HexabitzPlatform/H0FR9x-Hardware/README.md

# H0FR9x-Hardware
Hexabitz 230V/10A(RMS) Enhanced SPDT Relay Module Hardware Design
