HexabitzPlatform/H0FR9x-Hardware/Documentation/H0FR9 Schematics.pdf

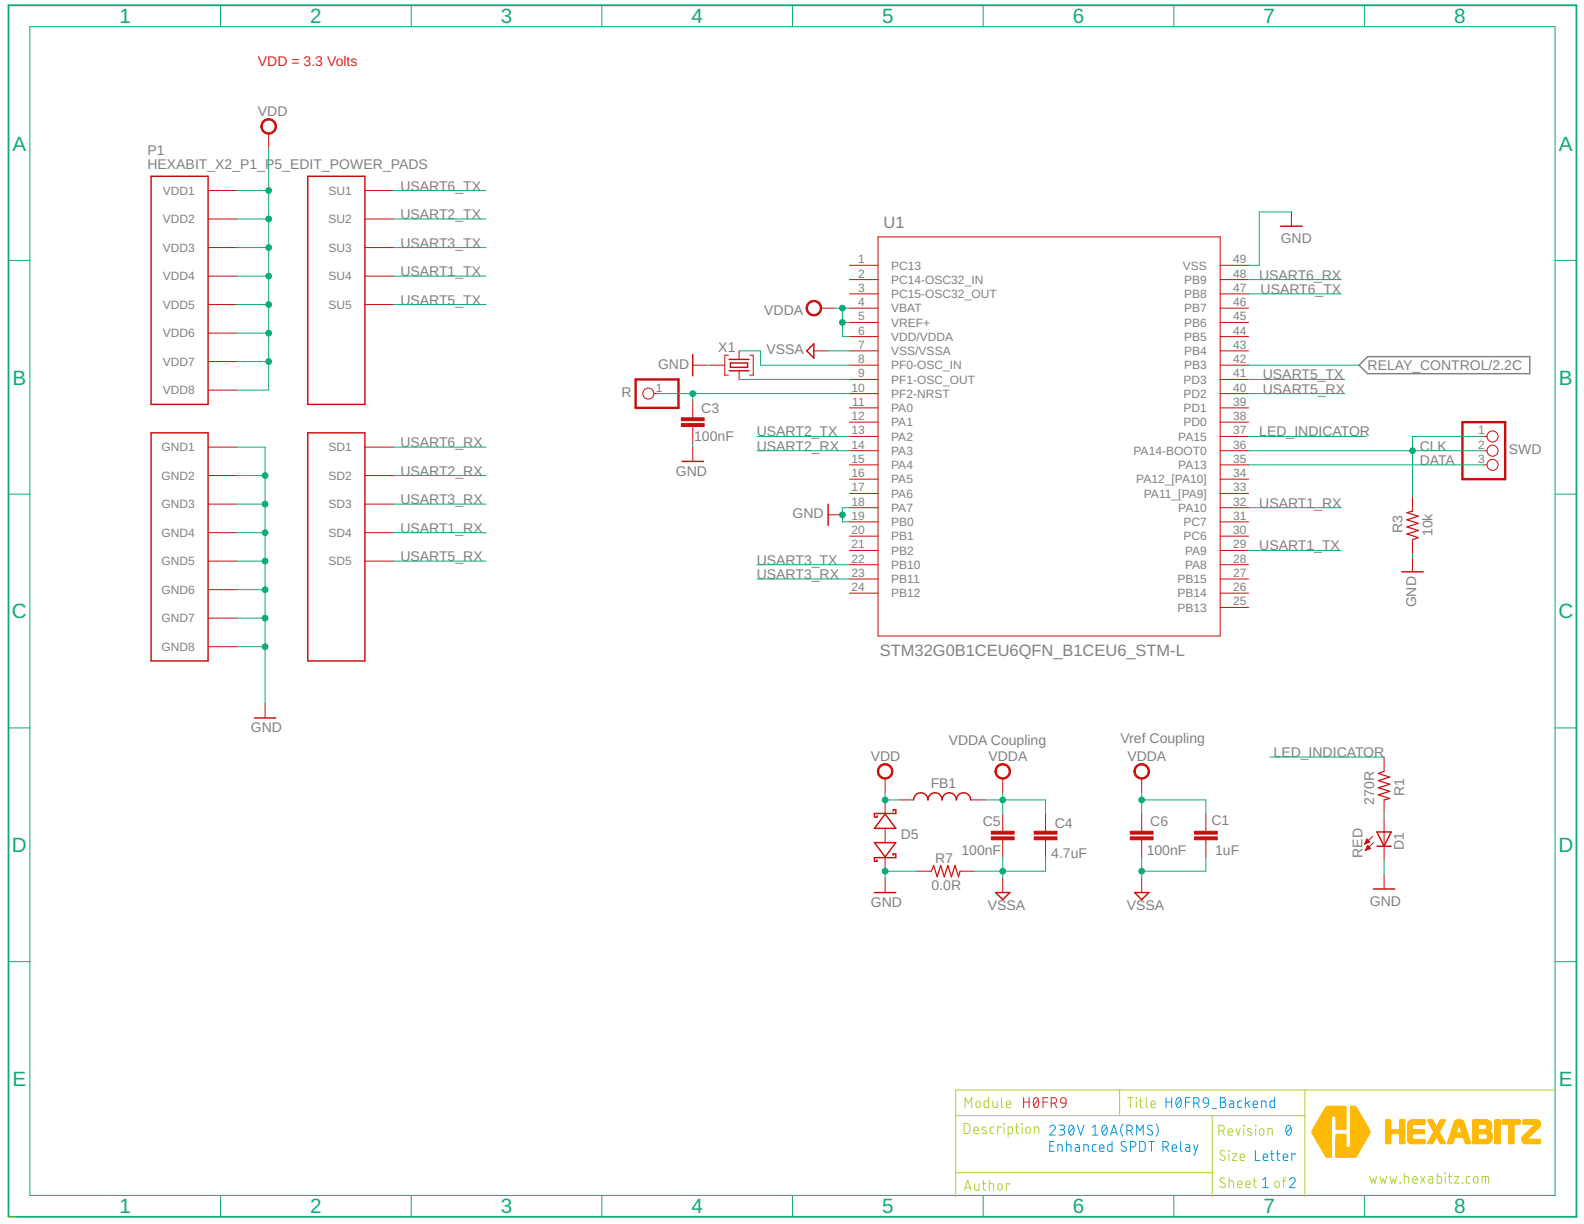
[picture p1: page 1]

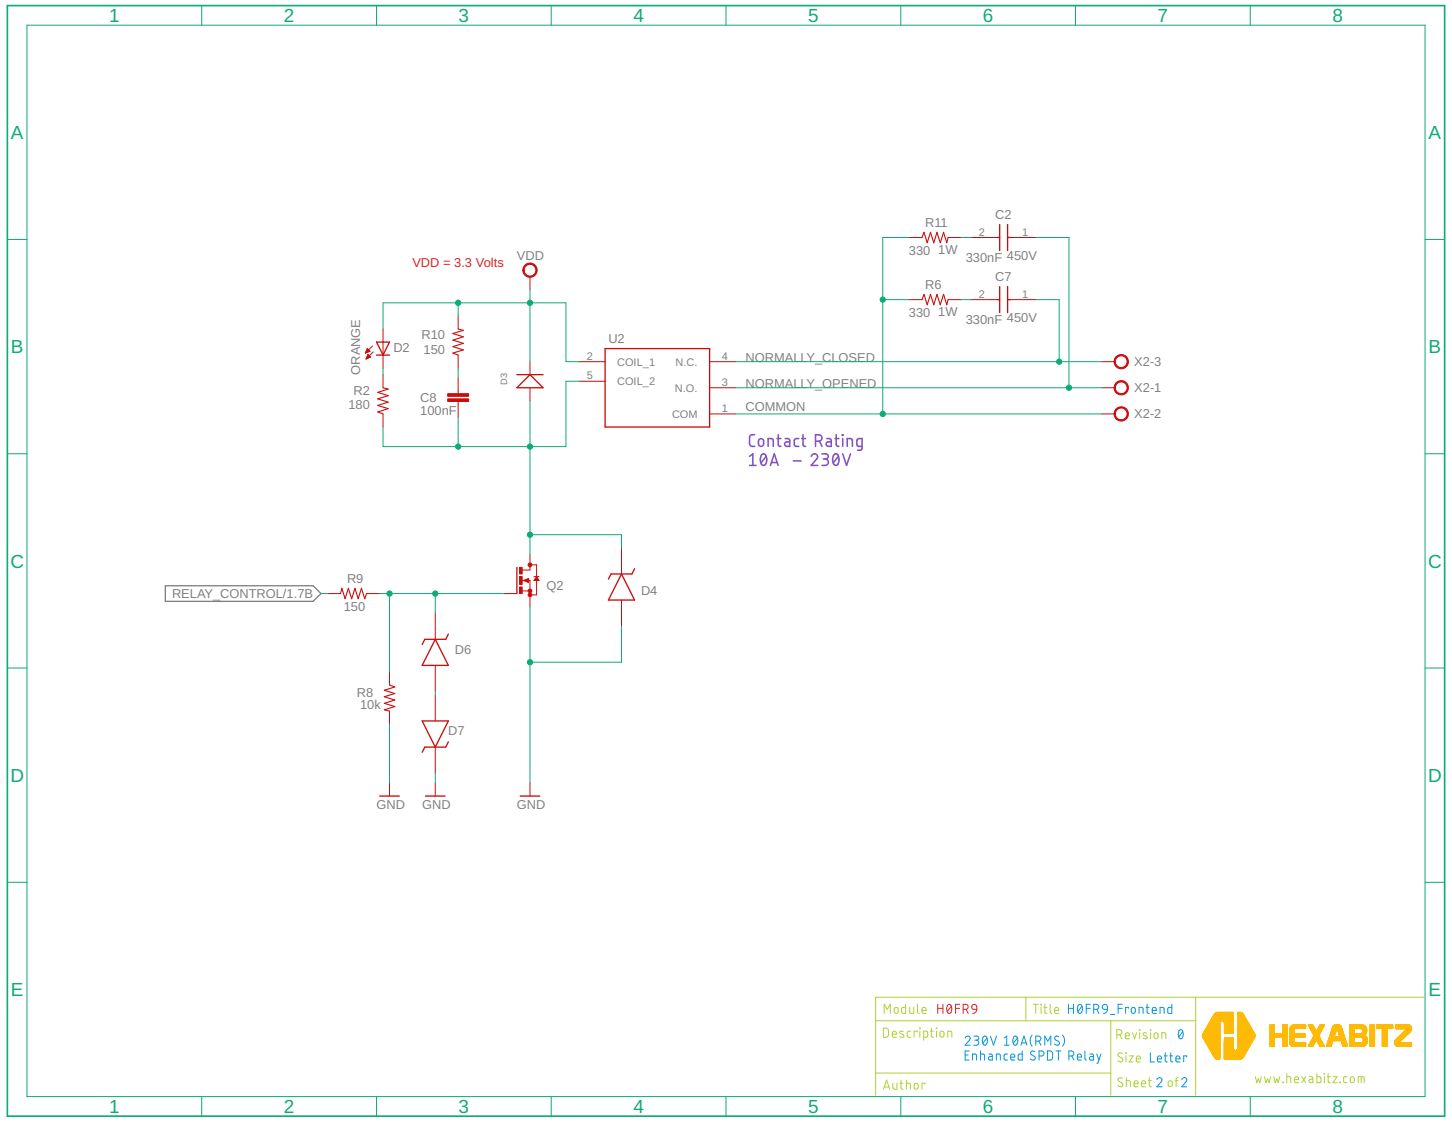
[picture p2: page 2]
