HexabitzPlatform/H0FR9x-Hardware/Design/H0FR9.brd

## EAGLE design Design/H0FR9.brd (2024-07-18)

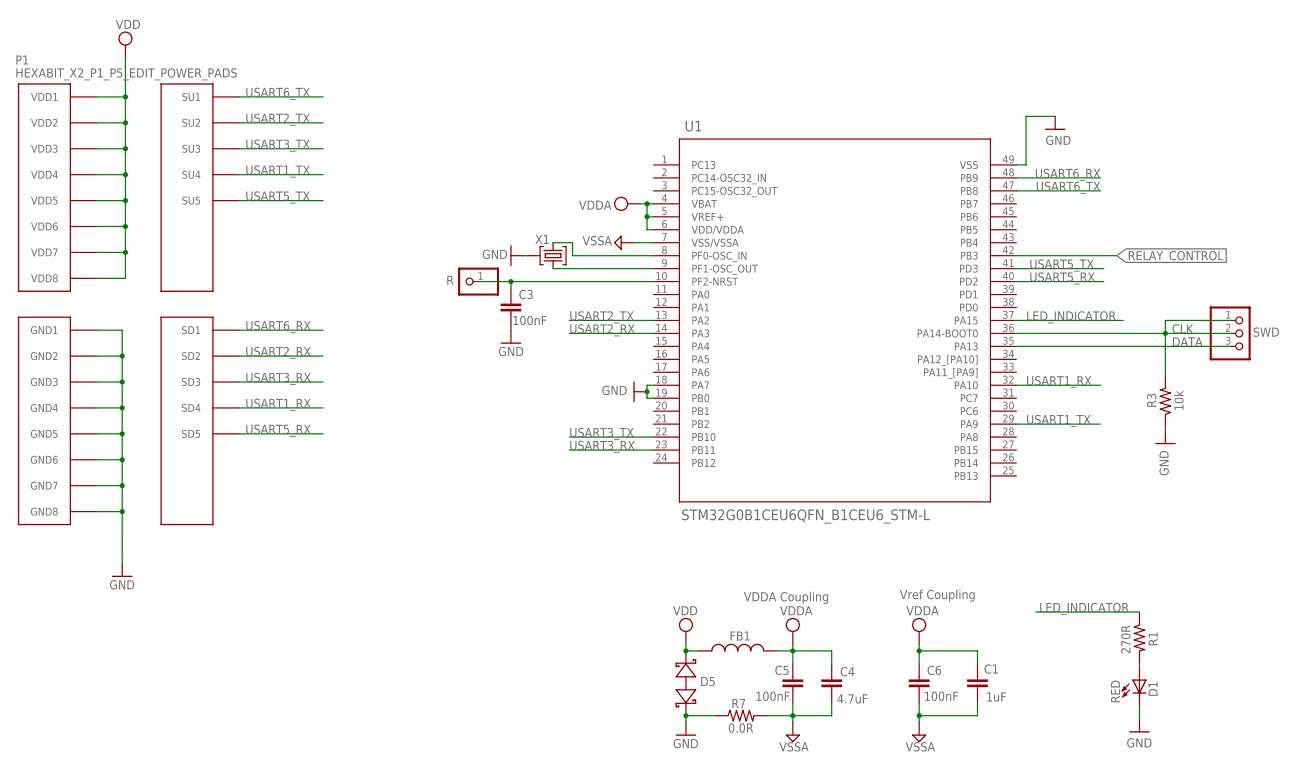
[picture p3: schematic H0FR9.sch, sheet 1]

Parts:
C1: 1uF; C-0805; TOLERANCE 10%; VOLTAGE_RATING 16V; MPN CC0805KKX7R7BB105
C3, C5: 100nF; C-0603
C4: 4.7uF; C-0805; TOLERANCE 10%; VOLTAGE_RATING 25V; MPN GRM21BC81E475KA12L
C6: 100nF; C-0603; TOLERANCE 10%; VOLTAGE_RATING 10V; MPN C0603C104K8RACTU
D1: RED; VLMS1300-GS08; MPN VLMS1300-GS08
D5: BOURNS_CDSOD323-T03SCBOURNS_CDSOD323-T03SC_0_0; BOURNS_CDSOD323-T03SC_0
FB1: FB-0603
P1: HEXABIT_X2_P1_P5_EDIT_POWER_PADS
R: R; 1X01
R1: 270R; R-0603
R3: 10k; R-0603; TOLERANCE 5%; MPN RC0603JR-0710KL
R7: 0.0R; R-0603
SWD: PINHD-1X3SWD; SWD
TRIMBLE-LOGO2: HEXA-LOGO
U1: STM32G0B1CEU6QFN_B1CEU6_STM-L; QFN_B1CEU6_STM-L
X1: XTALL_CSTCE8M00G52

Connections:
CLK: R3.2, SWD.1, SWD.2, U1.36 (PA14-BOOT0)
DATA: SWD.3, U1.35 (PA13)
GND: C3.2, D1.C, D5.2 (C), P1.PAD_PD11 (GND1), P1.PAD_PD12 (GND2), P1.PAD_PD13 (GND3), P1.PAD_PD14 (GND4), P1.PAD_PD17 (GND5), P1.PAD_PD18 (GND6), P1.PAD_PD19 (GND7), P1.PAD_PD20 (GND8), R3.1, R7.1, U1.18 (PA7), U1.19 (PB0), U1.49 (VSS), X1.P$2 (2); also elsewhere on the board
LED_INDICATOR: R1.1, U1.37 (PA15)
unnamed: D1.A, R1.2
unnamed: C3.1, R.1, U1.10 (PF2-NRST)
unnamed: U1.9 (PF1-OSC_OUT), X1.P$1 (1)
unnamed: U1.8 (PF0-OSC_IN), X1.P$3 (3)
RELAY_CONTROL: U1.42 (PB3); also elsewhere on the board
USART1_RX: P1.PAD_PD4 (SD4), U1.32 (PA10)
USART1_TX: P1.PAD_PU4 (SU4), U1.29 (PA9)
USART2_RX: P1.PAD_PD2 (SD2), U1.14 (PA3)
USART2_TX: P1.PAD_PU2 (SU2), U1.13 (PA2)
USART3_RX: P1.PAD_PD3 (SD3), U1.23 (PB11)
USART3_TX: P1.PAD_PU3 (SU3), U1.22 (PB10)
USART5_RX: P1.PAD_PD5 (SD5), U1.40 (PD2)
USART5_TX: P1.PAD_PU5 (SU5), U1.41 (PD3)
USART6_RX: P1.PAD_PD1 (SD1), U1.48 (PB9)
USART6_TX: P1.PAD_PU1 (SU1), U1.47 (PB8)
VDD: D5.1 (A), FB1.1, P1.PAD_PU11 (VDD1), P1.PAD_PU12 (VDD2), P1.PAD_PU13 (VDD3), P1.PAD_PU14 (VDD4), P1.PAD_PU17 (VDD5), P1.PAD_PU18 (VDD6), P1.PAD_PU19 (VDD7), P1.PAD_PU20 (VDD8); also elsewhere on the board
VDDA: C1.1, C4.1, C5.1, C6.1, FB1.2, U1.4 (VBAT), U1.5 (VREF+), U1.6 (VDD/VDDA)
VSSA: C1.2, C4.2, C5.2, C6.2, R7.2, U1.7 (VSS/VSSA)

Notes on the sheet:
Vref Coupling
VDDA Coupling

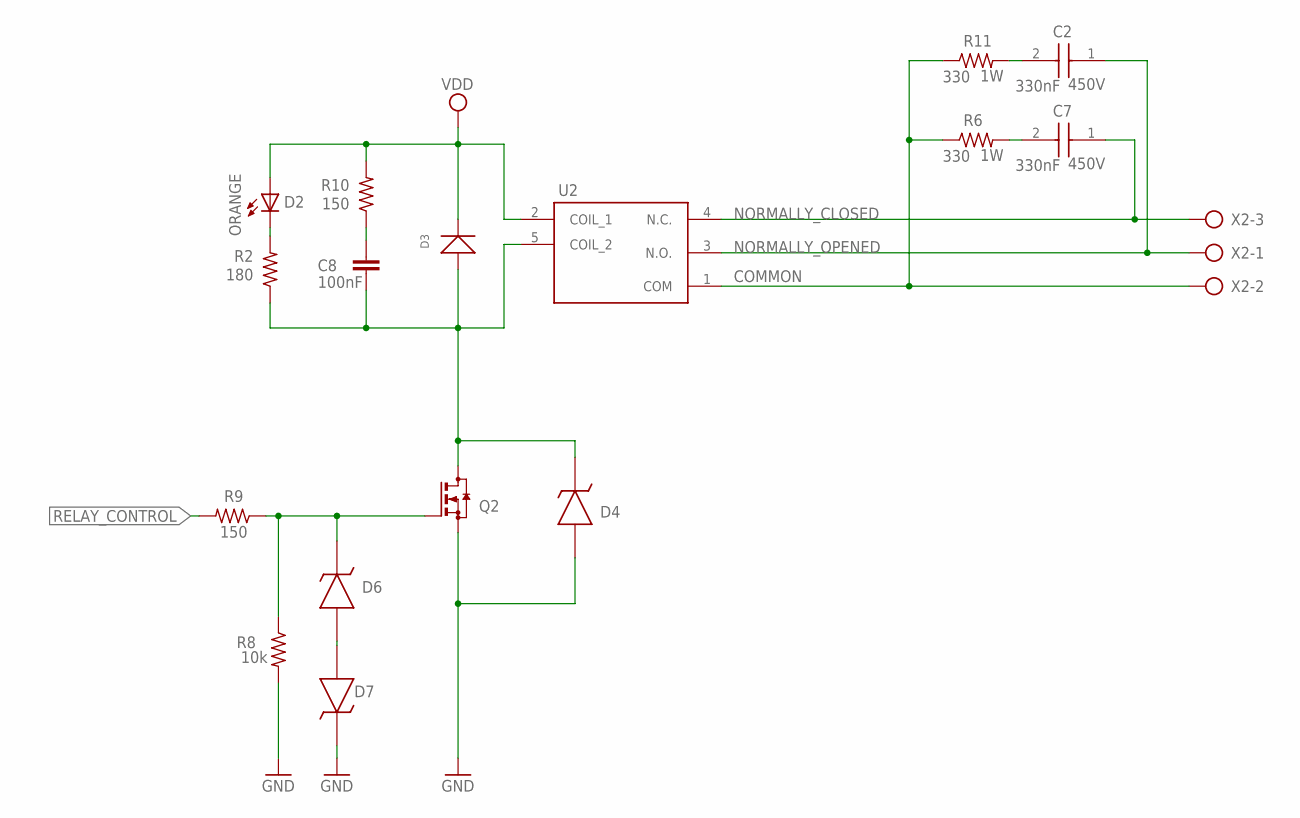
[picture p4: schematic H0FR9.sch, sheet 2]

Parts:
C2, C7: 330nF; B32922Q_(18_X_8.5)
C8: 100nF; C-0603; TOLERANCE 10%; VOLTAGE_RATING 10V; MPN C0603C104K8RACTU
D2: ORANGE; VLMS1300-GS08; MPN VLMY1300-GS08
D3: 40V 300MA; SOD-323
D4: MMSZ4705T1GMMSZ4705T1G; DIO_MMSZ4700T1G; MPN MMSZ4705T1G
D6, D7: MMSZ4705T1GMMSZ4705T1G; DIO_MMSZ4700T1G; MPN MMSZ5231BT3G
Q2: BSS123; SOT23
R2: 180; R-0603; TOLERANCE ±5%; MPN ERJ-3GEYJ181V
R6, R11: 330; R2512; MPN RMCF2512JT330R
R8: 10k; R-0603; TOLERANCE 5%; MPN RC0603JR-07680KL
R9, R10: 150; R-0603; TOLERANCE 5%; MPN RC0603JR-07680KL
U2: G5LE-14_DC3; G5LE-14_SPDT
X2: AK300/3; MPN 1715734

Connections:
COMMON: R6.1, R11.1, U2.1 (COM), X2.2
GND: D4.A, D7.K, Q2.2 (S), R8.2; also elsewhere on the board
unnamed: D6.A, D7.A
unnamed: D6.K, Q2.1 (G), R8.1, R9.1
unnamed: D2.C, R2.2
unnamed: C2.2, R11.2
unnamed: C8.1, R10.1
unnamed: C7.2, R6.2
unnamed: C8.2, D3.+, D4.K, Q2.3 (D), R2.1, U2.5 (COIL_2)
NORMALLY_CLOSED: C7.1, U2.4 (N.C.), X2.3
NORMALLY_OPENED: C2.1, U2.3 (N.O.), X2.1
RELAY_CONTROL: R9.2; also elsewhere on the board
VDD: D2.A, D3.-, R10.2, U2.2 (COIL_1); also elsewhere on the board

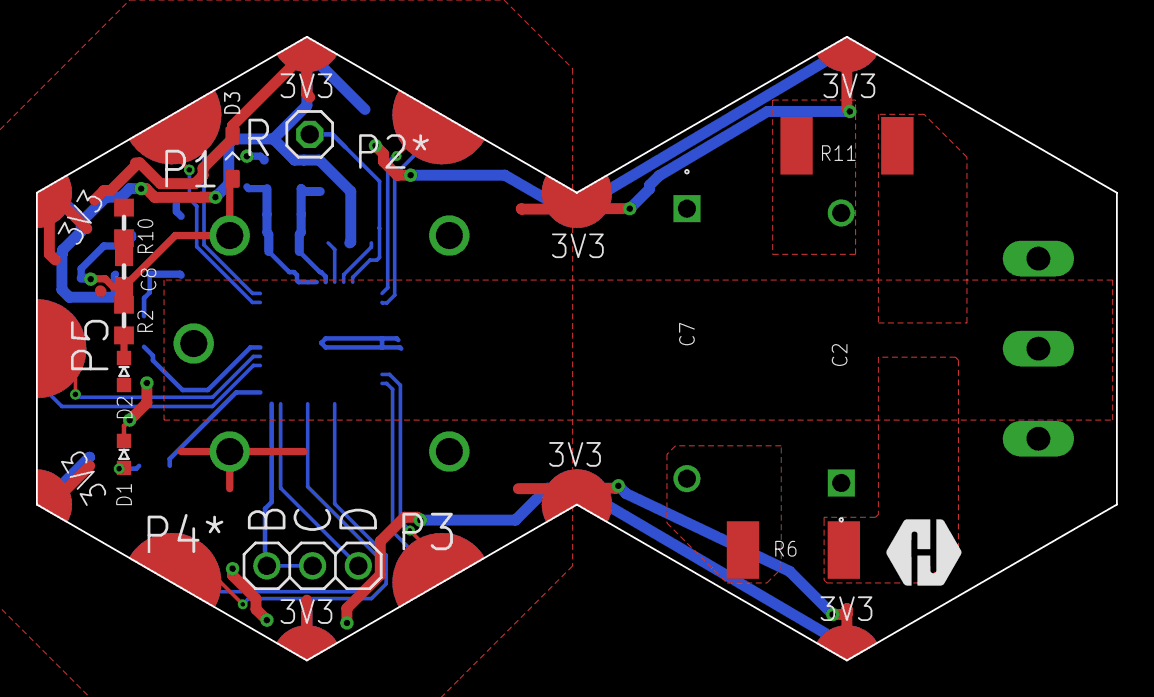
[picture p5: board H0FR9.brd from above]

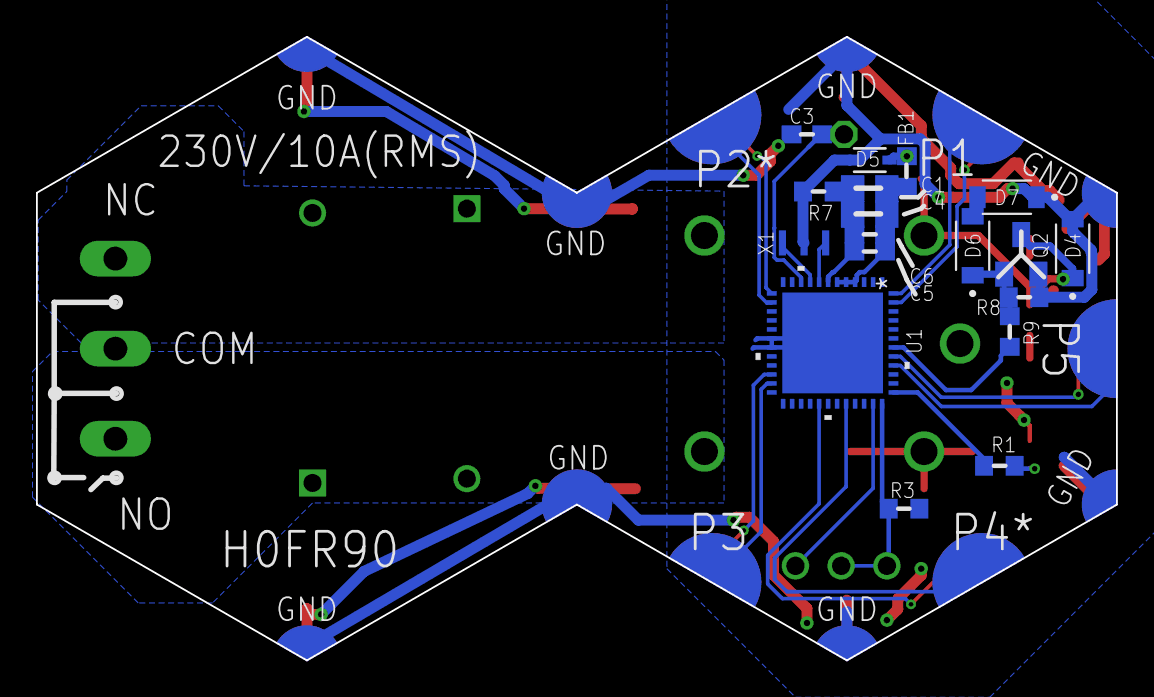
[picture p6: board H0FR9.brd from below]

Board: 2 copper layers, 60.0 x 34.6 mm, 34 parts (18 on the bottom side), 32 nets.
