HexabitzPlatform/H0FR9x-Hardware/(commit log)

2024-07-18 All finish, reviewed version
    [H0FR9.brd, H0FR9.sch, H0FR9.xlsx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]
2024-07-19 Fix BOM
    [H0FR9.xlsx]
